gunaltay-havacilik/valkyrie-v3-pcb/README.md

# Valkyrie Flight Control Computer V3.1

Made using primarily KiCad version 9.0<br/>
Some 3D files might not be assigned correctly. You have been warned.<br/>
Uses JLCPCB JLC04161H-7628 stackup, 4 layer.
