gunaltay-havacilik/valkyrie-v3-pcb/3d-files/SMA CONNECTOR--3DModel-STEP-1.STEP

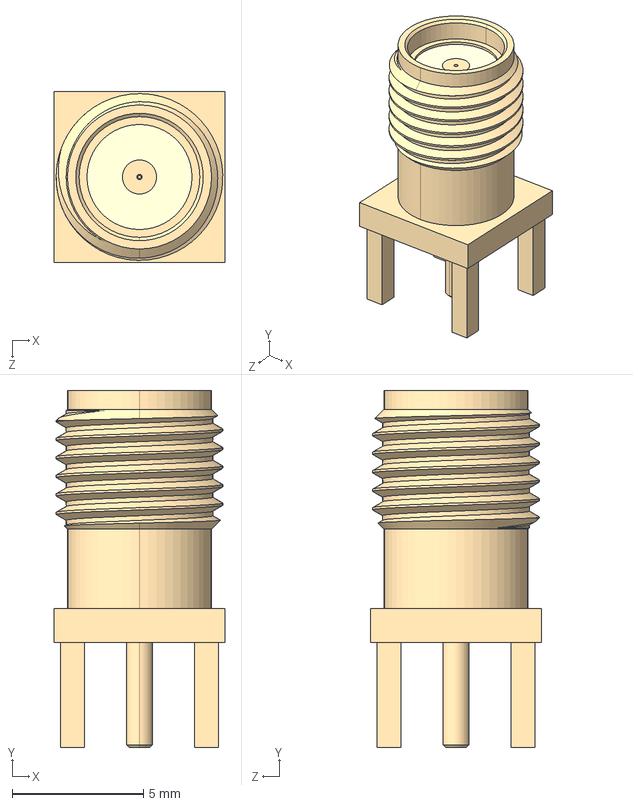
[picture p1: CAD file, 2025-05-14]
3d-files/SMA CONNECTOR--3DModel-STEP-1.STEP
6.50 x 13.6 x 6.50 mm
