gunaltay-havacilik/valkyrie-v3-pcb/3d-files/XH311HU-IV07E--3DModel-STEP-269445.STEP

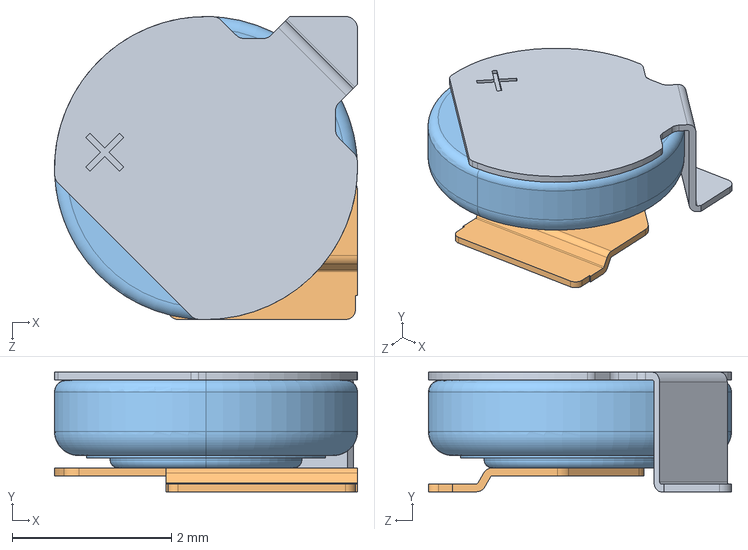
[picture p3: CAD file, 2025-02-26]
3d-files/XH311HU-IV07E--3DModel-STEP-269445.STEP
3.80 x 1.50 x 3.80 mm
