gunaltay-havacilik/valkyrie-v3-pcb/3d-files/CON-SMA-EDGE-S.step

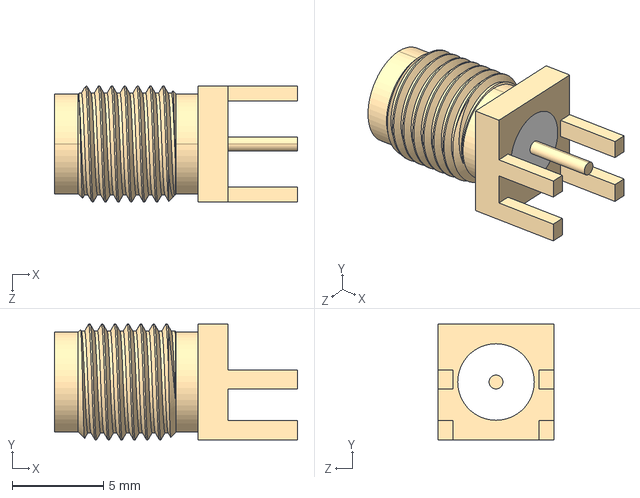
[picture p4: CAD file, 2025-02-26]
3d-files/CON-SMA-EDGE-S.step
13.3 x 6.35 x 6.35 mm
