gunaltay-havacilik/valkyrie-v3-pcb/3d-files/DR125 series.stp

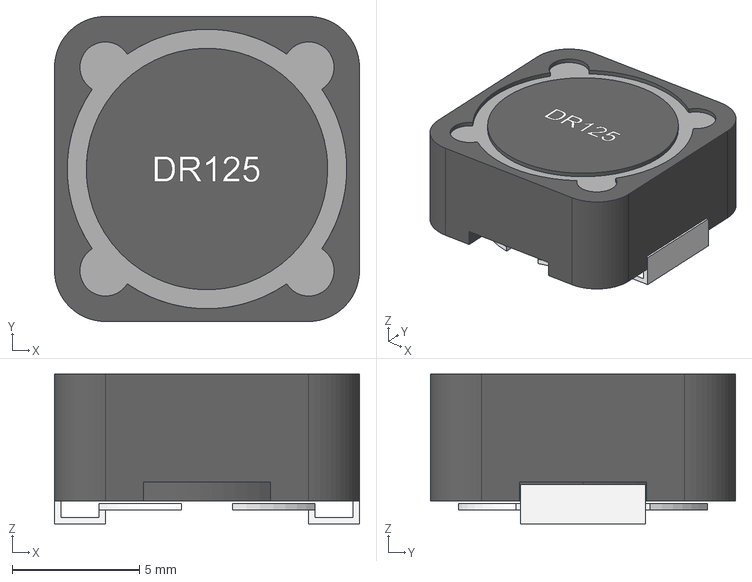
[picture p5: CAD file, 2025-02-26]
3d-files/DR125 series.stp
12.0 x 12.0 x 5.90 mm
