gunaltay-havacilik/valkyrie-v3-pcb/3d-files/L86-M33--3DModel-STEP-56544.STEP

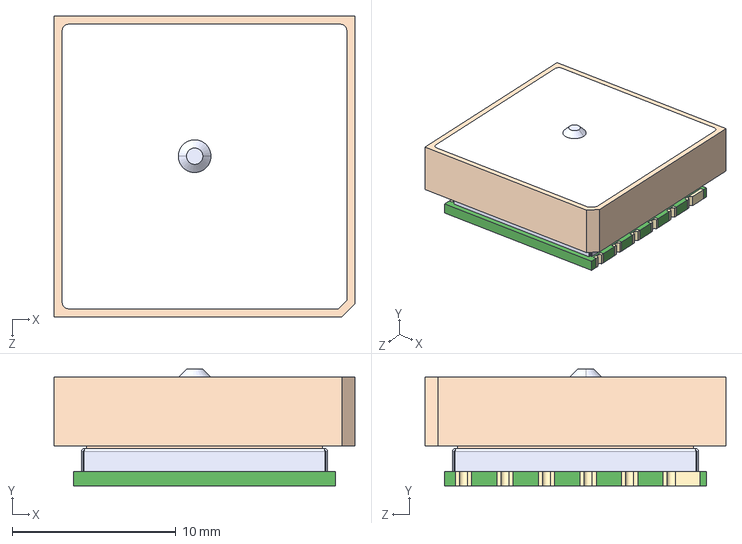
[picture p6: CAD file, 2025-02-26]
3d-files/L86-M33--3DModel-STEP-56544.STEP
18.4 x 7.15 x 18.4 mm
