gunaltay-havacilik/valkyrie-v3-pcb/3d-files/E22-400T30XX.stp

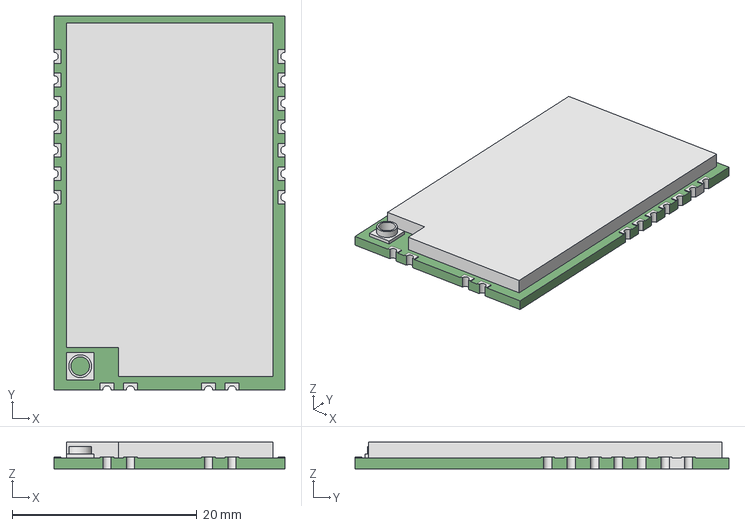
[picture p7: CAD file, 2025-02-26]
3d-files/E22-400T30XX.stp
25.0 x 40.5 x 2.90 mm
