gunaltay-havacilik/valkyrie-v3-pcb/3d-files/XT30PW-M--3DModel-STEP-269445.STEP

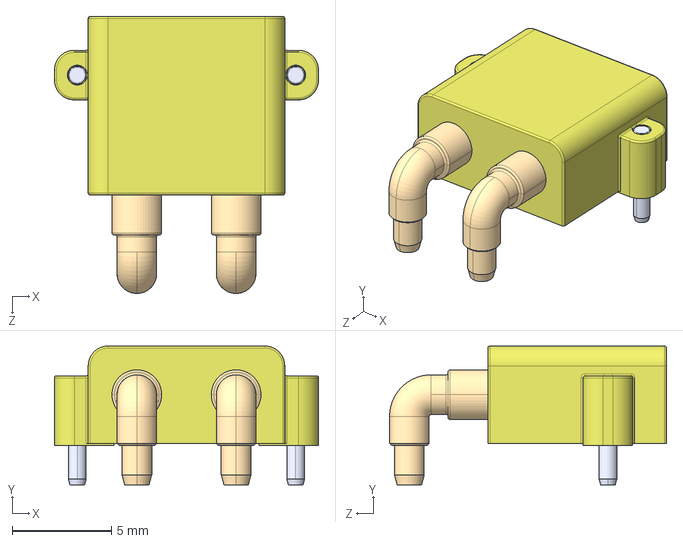
[picture p8: CAD file, 2025-02-26]
3d-files/XT30PW-M--3DModel-STEP-269445.STEP
13.3 x 7.00 x 14.0 mm
