gunaltay-havacilik/valkyrie-v3-pcb/valkyriev3.kicad_pcb

## KiCad design valkyriev3.kicad_pcb (2025-08-03)

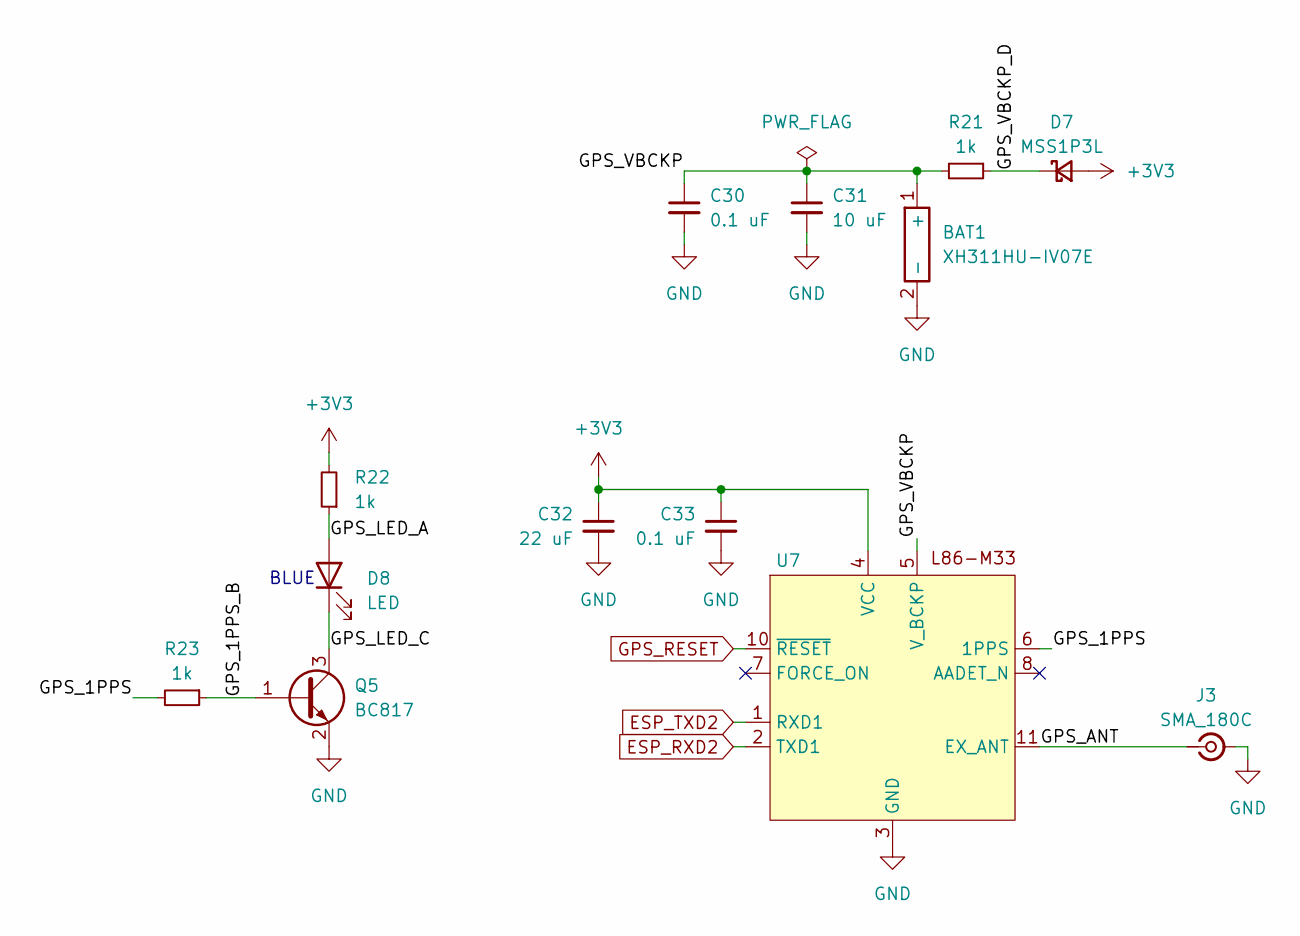
[picture p9: schematic GPS.kicad_sch, Valkyrie Flight Computer V3]

Parts:
BAT1: XH311HU-IV07E
C30, C33: 0.1 uF; C_0603_1608Metric
C31: 10 uF; C_0603_1608Metric
C32: 22 uF; C_0603_1608Metric
D7: MSS1P3L; D_MicroSMP_AK
D8: LED; LED_0603_1608Metric
J3: SMA_180C; SMA_Amphenol_132134-16_Vertical
Q5: BC817; SOT-23
R21, R22, R23: 1k; R_0603_1608Metric
U7: Quectel_L86-M33

Connections:
+3V3: C32.1, C33.1, D7.2 (A), R22.2, U7.4 (VCC); also elsewhere on the board
/GPS/GPS_1PPS: R23.2, U7.6 (1PPS)
/GPS/GPS_1PPS_B: Q5.1 (B), R23.1
/GPS/GPS_ANT: J3.1 (In), U7.11 (EX_ANT)
/GPS/GPS_LED_A: D8.2 (A), R22.1
/GPS/GPS_LED_C: D8.1 (K), Q5.3 (C)
/GPS/GPS_VBCKP: BAT1.1 (+), C30.1, C31.1, R21.2, U7.5 (V_BCKP)
/GPS/GPS_VBCKP_D: D7.1 (K), R21.1
ESP_RXD2: U7.2 (TXD1); also elsewhere on the board
ESP_TXD2: U7.1 (RXD1); also elsewhere on the board
GND: BAT1.2 (-), C30.2, C31.2, C32.2, C33.2, J3.2 (Ext), Q5.2 (E), U7.3 (GND), U7.12 (GND); also elsewhere on the board
GPS_RESET: U7.10 (~RESET); also elsewhere on the board

Notes on the sheet:
BLUE

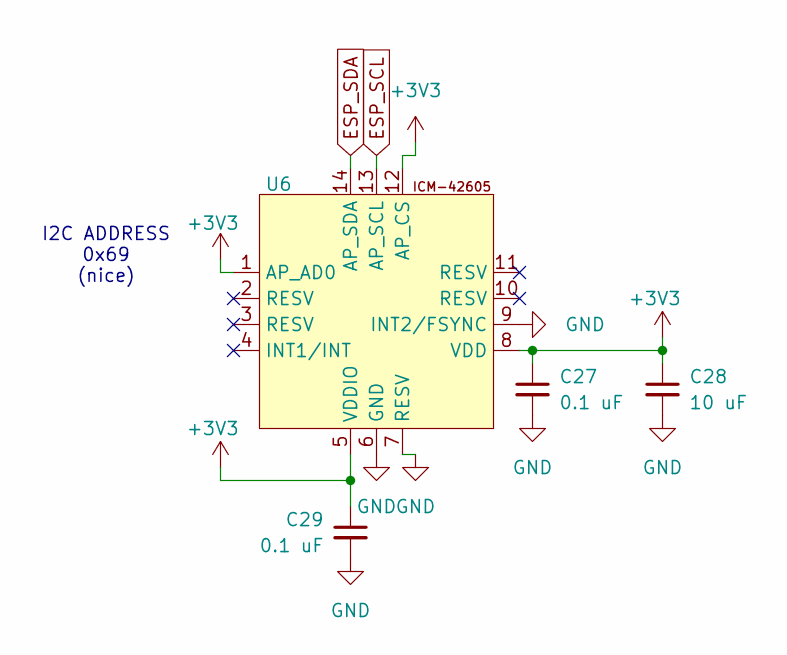
[picture p10: schematic IMU.kicad_sch, Valkyrie Flight Computer V3]

Parts:
C27, C29: 0.1 uF; C_0603_1608Metric
C28: 10 uF; C_0603_1608Metric
U6: LGA-14_3x2.5mm_P0.5mm_LayoutBorder3x4y

Connections:
+3V3: C27.1, C28.1, C29.1, U6.1 (AP_AD0), U6.5 (VDDIO), U6.8 (VDD), U6.12 (AP_CS); also elsewhere on the board
ESP_SCL: U6.13 (AP_SCL); also elsewhere on the board
ESP_SDA: U6.14 (AP_SDA); also elsewhere on the board
GND: C27.2, C28.2, C29.2, U6.6 (GND), U6.7 (RESV), U6.9 (INT2/FSYNC); also elsewhere on the board

Notes on the sheet:
I2C ADDRESS 0x69 (nice)

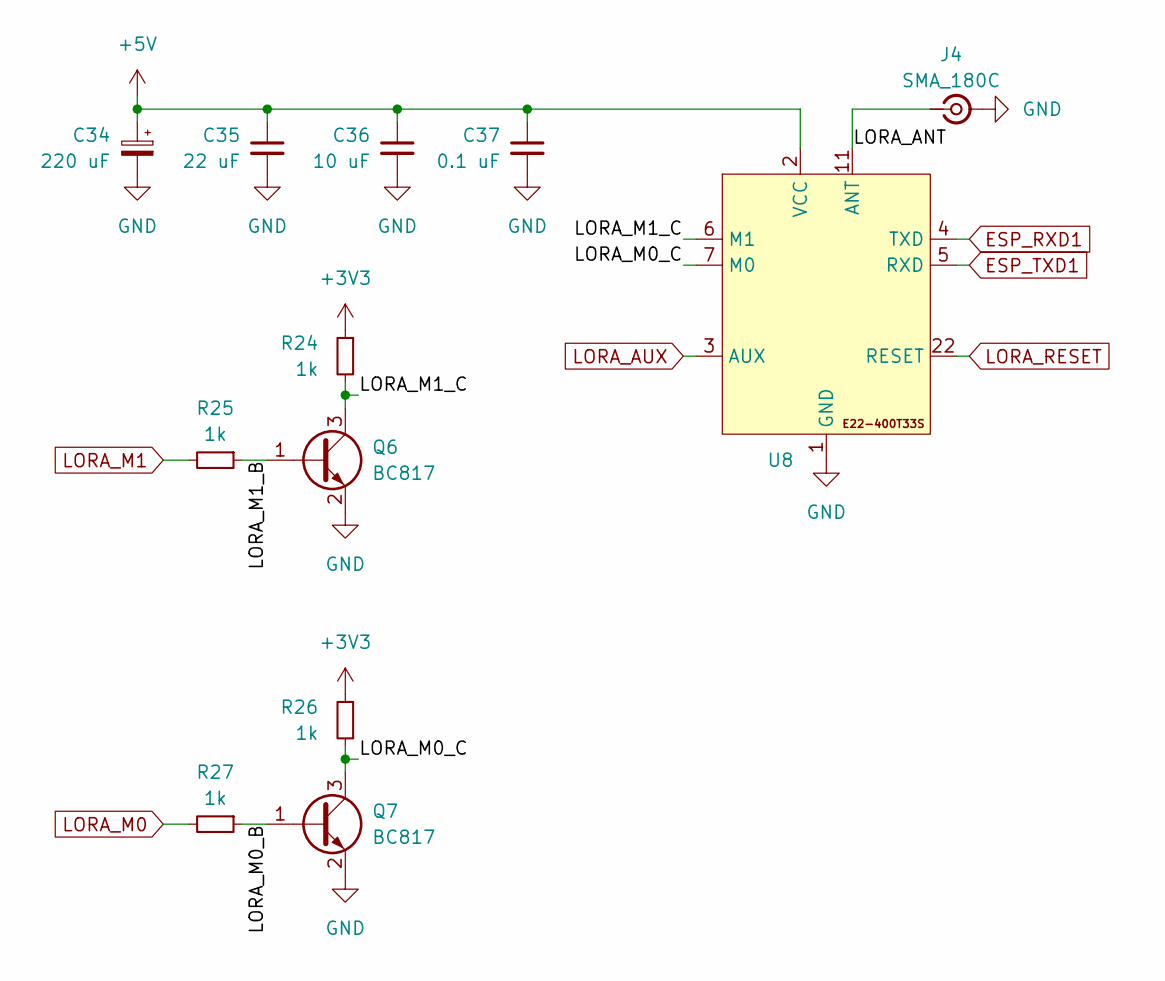
[picture p11: schematic communications.kicad_sch, Valkyrie Flight Computer V3]

Parts:
C34: 220 uF; CP_Elec_6.3x7.7
C35: 22 uF; C_0603_1608Metric
C36: 10 uF; C_0603_1608Metric
C37: 0.1 uF; C_0603_1608Metric
J4: SMA_180C; SMA_Amphenol_132134-16_Vertical
Q6, Q7: BC817; SOT-23
R24, R25, R26, R27: 1k; R_0603_1608Metric
U8: E22-400T33S

Connections:
+3V3: R24.1, R26.1; also elsewhere on the board
+5V: C34.1, C35.1, C36.1, C37.1, U8.2 (VCC); also elsewhere on the board
/Communications/LORA_ANT: J4.1 (In), U8.11 (ANT)
/Communications/LORA_M0_B: Q7.1 (B), R27.1
/Communications/LORA_M0_C: Q7.3 (C), R26.2, U8.7 (M0)
/Communications/LORA_M1_B: Q6.1 (B), R25.1
/Communications/LORA_M1_C: Q6.3 (C), R24.2, U8.6 (M1)
ESP_RXD1: U8.4 (TXD); also elsewhere on the board
ESP_TXD1: U8.5 (RXD); also elsewhere on the board
GND: C34.2, C35.2, C36.2, C37.2, J4.2 (Ext), Q6.2 (E), Q7.2 (E), U8.1 (GND), U8.12 (GND), U8.13 (GND), U8.14 (GND), U8.23 (GND); also elsewhere on the board
LORA_AUX: U8.3 (AUX); also elsewhere on the board
LORA_M0: R27.2; also elsewhere on the board
LORA_M1: R25.2; also elsewhere on the board
LORA_RESET: U8.22 (RESET); also elsewhere on the board

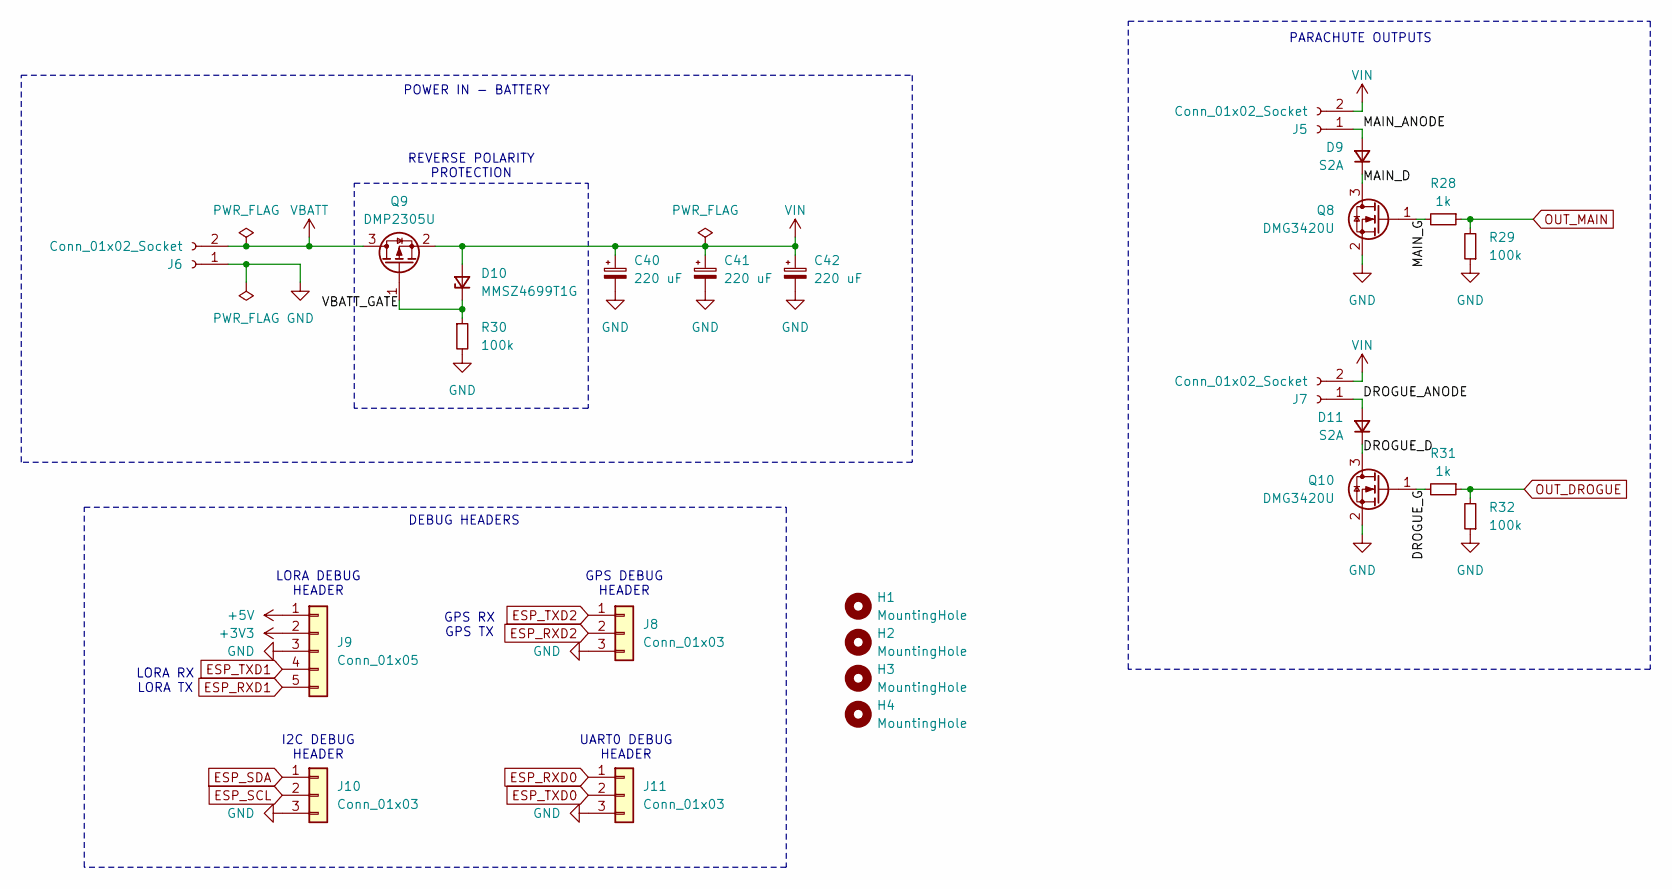
[picture p12: schematic connectors.kicad_sch, Valkyrie Flight Computer V3]

Parts:
C40, C41, C42: 220 uF; CP_Elec_6.3x7.7
D9, D11: S2A; D_SMB
D10: MMSZ4699T1G; D_SOD-123
H1, H2, H3, H4: MountingHole; MountingHole_2.2mm_M2
J5, J6, J7: Conn_01x02_Socket; AMASS_XT30PW-M_1x02_P2.50mm_Horizontal
J8, J10, J11: Conn_01x03; PinHeader_1x03_P2.54mm_Vertical
J9: Conn_01x05; PinHeader_1x05_P2.54mm_Vertical
Q8, Q10: DMG3420U; SOT-23
Q9: DMP2305U; SOT-23
R28, R31: 1k; R_0603_1608Metric
R29, R30, R32: 100k; R_0603_1608Metric

Connections:
+3V3: J9.2; also elsewhere on the board
+5V: J9.1; also elsewhere on the board
/Connectors/DROGUE_ANODE: D11.2 (A), J7.1
/Connectors/DROGUE_D: D11.1 (K), Q10.3 (D)
/Connectors/DROGUE_G: Q10.1 (G), R31.2
/Connectors/MAIN_ANODE: D9.2 (A), J5.1
/Connectors/MAIN_D: D9.1 (K), Q8.3 (D)
/Connectors/MAIN_G: Q8.1 (G), R28.2
/Connectors/VBATT_GATE: D10.1 (K), Q9.1 (G), R30.1
ESP_RXD0: J11.1; also elsewhere on the board
ESP_RXD1: J9.5; also elsewhere on the board
ESP_RXD2: J8.2; also elsewhere on the board
ESP_SCL: J10.2; also elsewhere on the board
ESP_SDA: J10.1; also elsewhere on the board
ESP_TXD0: J11.2; also elsewhere on the board
ESP_TXD1: J9.4; also elsewhere on the board
ESP_TXD2: J8.1; also elsewhere on the board
GND: C40.2, C41.2, C42.2, J6.1, J8.3, J9.3, J10.3, J11.3, Q8.2 (S), Q10.2 (S), R29.1, R30.2, R32.1; also elsewhere on the board
OUT_DROGUE: R31.1, R32.2; also elsewhere on the board
OUT_MAIN: R28.1, R29.2; also elsewhere on the board
VBATT: J6.2, Q9.3 (D)
VIN: C40.1, C41.1, C42.1, D10.2 (A), J5.2, J7.2, Q9.2 (S); also elsewhere on the board

Notes on the sheet:
LORA DEBUG HEADER
POWER IN - BATTERY
LORA RX LORA TX
PARACHUTE OUTPUTS
I2C DEBUG HEADER
UART0 DEBUG HEADER
DEBUG HEADERS
REVERSE POLARITY PROTECTION
GPS DEBUG HEADER
GPS RX GPS TX

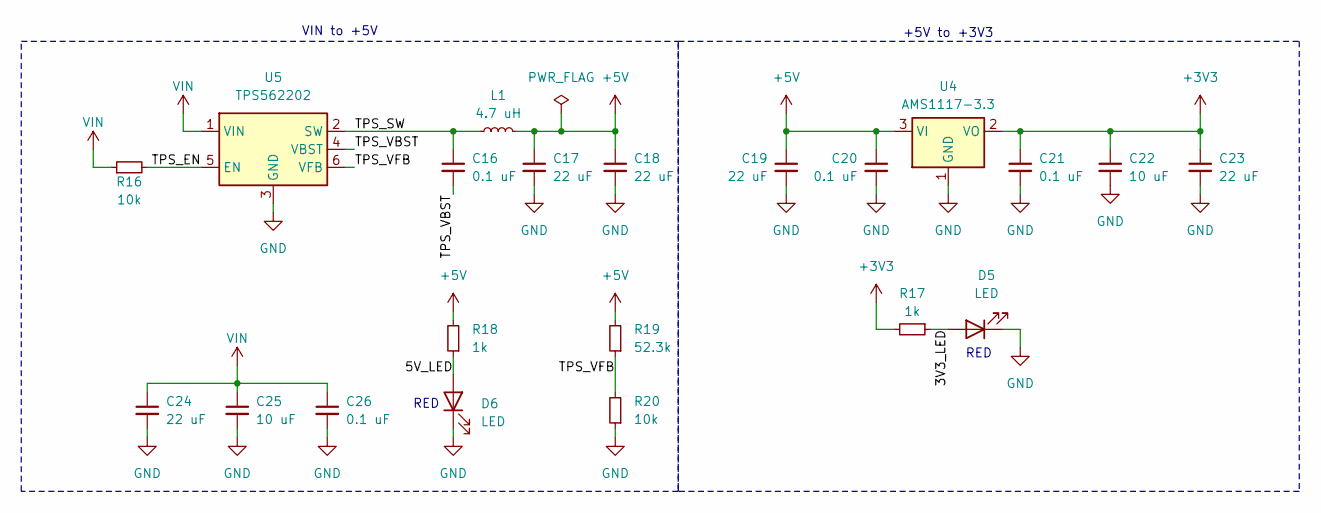
[picture p13: schematic power.kicad_sch, Valkyrie Flight Computer V3]

Parts:
C16, C20, C21: 0.1 uF; C_0603_1608Metric
C17, C18, C19, C23: 22 uF; C_0603_1608Metric
C22: 10 uF; C_0603_1608Metric
C24: 22 uF; C_0805_2012Metric
C25: 10 uF; C_0805_2012Metric
C26: 0.1 uF; C_0805_2012Metric
D5, D6: LED; LED_0603_1608Metric
L1: 4.7 uH; HPC 5020NF
R16, R20: 10k; R_0603_1608Metric
R17, R18: 1k; R_0603_1608Metric
R19: 52.3k; R_0603_1608Metric
U4: AMS1117-3.3; SOT-223-3_TabPin2
U5: TPS562202; SOT-563

Connections:
+3V3: C21.1, C22.1, C23.1, R17.2, U4.2 (VO); also elsewhere on the board
+5V: C17.1, C18.1, C19.1, C20.1, L1.2, R18.2, R19.2, U4.3 (VI); also elsewhere on the board
/Power/3V3_LED: D5.2 (A), R17.1
/Power/5V_LED: D6.2 (A), R18.1
/Power/TPS_EN: R16.2, U5.5 (EN)
/Power/TPS_SW: C16.1, L1.1, U5.2 (SW)
/Power/TPS_VBST: C16.2, U5.4 (VBST)
/Power/TPS_VFB: R19.1, R20.2, U5.6 (VFB)
GND: C17.2, C18.2, C19.2, C20.2, C21.2, C22.2, C23.2, C24.2, C25.2, C26.2, D5.1 (K), D6.1 (K), R20.1, U4.1 (GND), U5.3 (GND); also elsewhere on the board
VIN: C24.1, C25.1, C26.1, R16.1, U5.1 (VIN); also elsewhere on the board

Notes on the sheet:
RED
VIN to +5V
+5V to +3V3

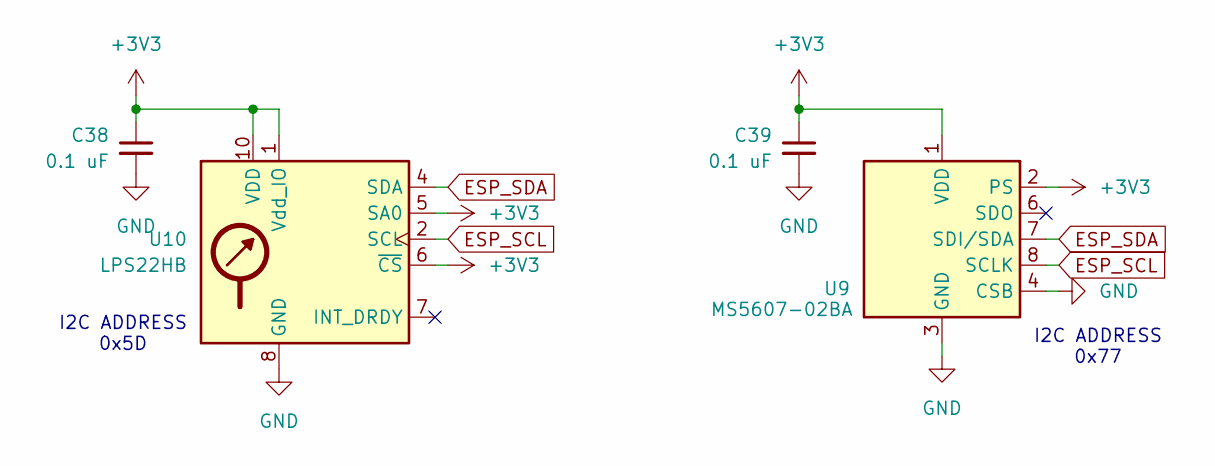
[picture p14: schematic Baro.kicad_sch, Valkyrie Flight Computer V3]

Parts:
C38, C39: 0.1 uF; C_0603_1608Metric
U9: MS5607-02BA; LGA-8_3x5mm_P1.25mm
U10: LPS22HB; ST_HLGA-10_2x2mm_P0.5mm_LayoutBorder3x2y

Connections:
+3V3: C38.1, C39.1, U9.1 (VDD), U9.2 (PS), U10.1 (Vdd_IO), U10.5 (SA0), U10.6 (~CS), U10.10 (VDD); also elsewhere on the board
ESP_SCL: U9.8 (SCLK), U10.2 (SCL); also elsewhere on the board
ESP_SDA: U9.7 (SDI/SDA), U10.4 (SDA); also elsewhere on the board
GND: C38.2, C39.2, U9.3 (GND), U9.4 (CSB), U9.5 (CSB), U10.3 (GND), U10.8 (GND), U10.9 (GND); also elsewhere on the board

Notes on the sheet:
I2C ADDRESS 0x5D
I2C ADDRESS 0x77

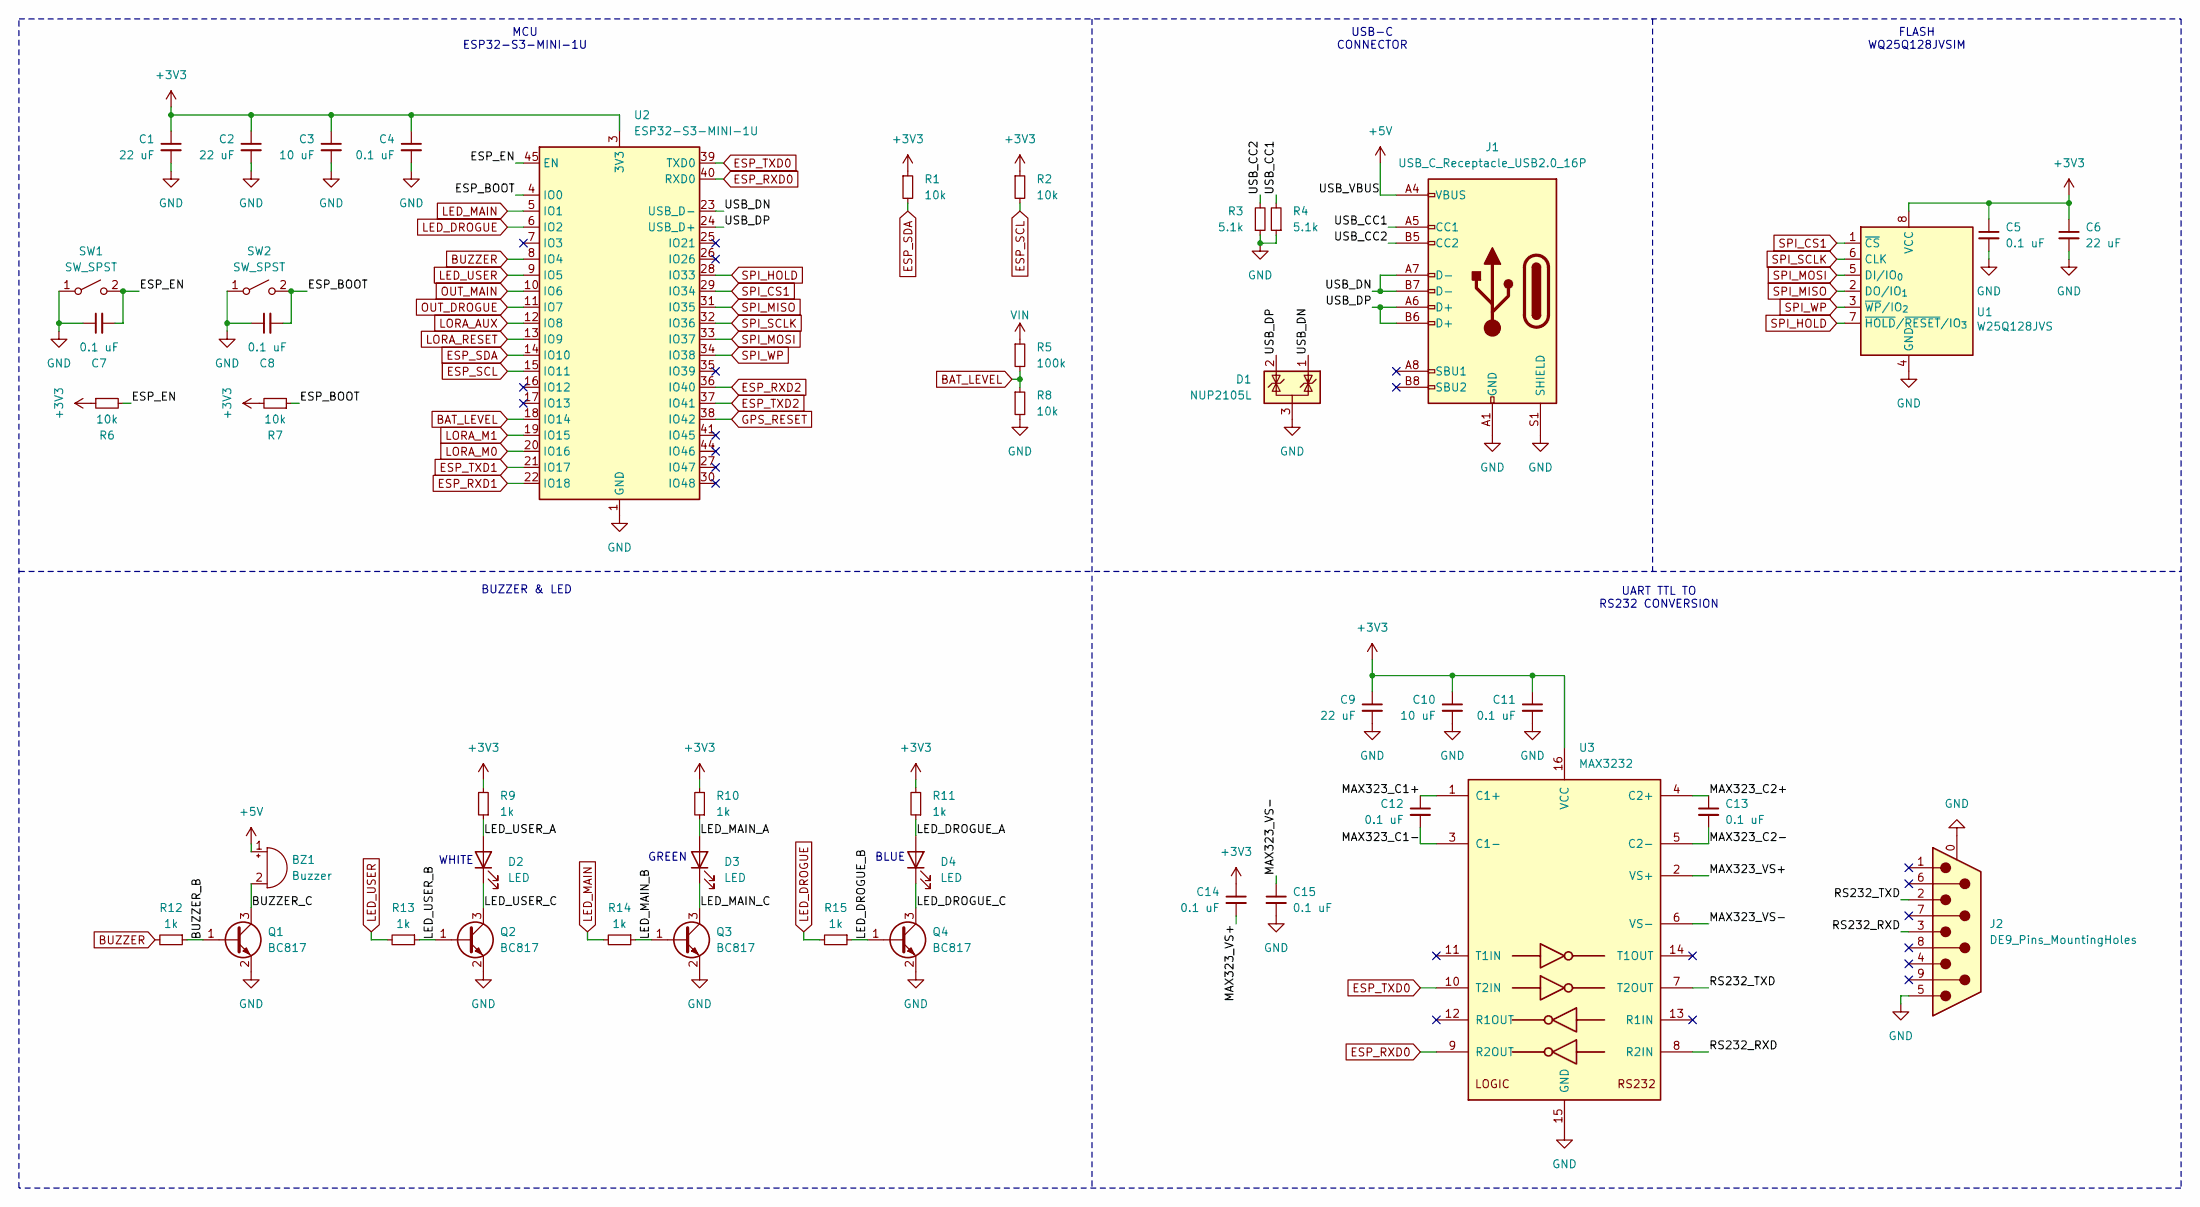
[picture p15: schematic MCU.kicad_sch, Valkyrie Flight Computer V3]

Parts:
BZ1: Buzzer; Buzzer_12x9.5RM7.6
C1, C2, C6, C9: 22 uF; C_0603_1608Metric
C3, C10: 10 uF; C_0603_1608Metric
C4, C5, C7, C8, C11, C12, C13, C14, C15: 0.1 uF; C_0603_1608Metric
D1: NUP2105L; SOT-23
D2, D3, D4: LED; LED_0603_1608Metric
J1: USB_C_Receptacle_USB2.0_16P; USB_C_Receptacle_GCT_USB4105-xx-A_16P_TopMnt_Horizontal
J2: DE9_Pins_MountingHoles; DSUB-9_Pins_Horizontal_P2.77x2.84mm_EdgePinOffset7.70mm_Hou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
Q1, Q2, Q3, Q4: BC817; SOT-23
R1, R2, R6, R7, R8: 10k; R_0603_1608Metric
R3, R4: 5.1k; R_0603_1608Metric
R5: 100k; R_0603_1608Metric
R9, R10, R11, R12, R13, R14, R15: 1k; R_0603_1608Metric
SW1, SW2: SW_SPST; SW_Tactile_SPST_NO_Straight_CK_PTS636Sx25SMTRLFS
U1: W25Q128JVS; SOIC-8_5.3x5.3mm_P1.27mm
U2: ESP32-S3-MINI-1U; ESP32-S2-MINI-1U
U3: MAX3232; TSSOP-16_4.4x5mm_P0.65mm

Connections:
+3V3: C1.1, C2.1, C3.1, C4.1, C5.1, C6.1, C9.1, C10.1, C11.1, C14.1, R1.1, R2.1, R6.1, R7.2, R9.2, R10.2, R11.2, U1.8 (VCC), U2.3 (3V3), U3.16 (VCC); also elsewhere on the board
+5V: BZ1.1 (+), J1.A4 (VBUS), J1.A9 (VBUS), J1.B4 (VBUS), J1.B9 (VBUS); also elsewhere on the board
/MCU/BUZZER_B: Q1.1 (B), R12.1
/MCU/BUZZER_C: BZ1.2 (-), Q1.3 (C)
/MCU/ESP_BOOT: C8.2, R7.1, SW2.2 (B), U2.4 (IO0)
/MCU/ESP_EN: C7.2, R6.2, SW1.2 (B), U2.45 (EN)
/MCU/LED_DROGUE_A: D4.2 (A), R11.1
/MCU/LED_DROGUE_B: Q4.1 (B), R15.1
/MCU/LED_DROGUE_C: D4.1 (K), Q4.3 (C)
/MCU/LED_MAIN_A: D3.2 (A), R10.1
/MCU/LED_MAIN_B: Q3.1 (B), R14.1
/MCU/LED_MAIN_C: D3.1 (K), Q3.3 (C)
/MCU/LED_USER_A: D2.2 (A), R9.1
/MCU/LED_USER_B: Q2.1 (B), R13.1
/MCU/LED_USER_C: D2.1 (K), Q2.3 (C)
/MCU/MAX323_C1+: C12.1, U3.1 (C1+)
/MCU/MAX323_C1-: C12.2, U3.3 (C1-)
/MCU/MAX323_C2+: C13.1, U3.4 (C2+)
/MCU/MAX323_C2-: C13.2, U3.5 (C2-)
/MCU/MAX323_VS+: C14.2, U3.2 (VS+)
/MCU/MAX323_VS-: C15.1, U3.6 (VS-)
/MCU/RS232_RXD: J2.3, U3.8 (R2IN)
/MCU/RS232_TXD: J2.2, U3.7 (T2OUT)
/MCU/USB_CC1: J1.A5 (CC1), R4.2
/MCU/USB_CC2: J1.B5 (CC2), R3.2
/MCU/USB_DN: D1.1 (K), J1.A7 (D-), J1.B7 (D-), U2.23 (USB_D-)
/MCU/USB_DP: D1.2 (K), J1.A6 (D+), J1.B6 (D+), U2.24 (USB_D+)
BAT_LEVEL: R5.2, R8.1, U2.18 (IO14)
BUZZER: R12.2, U2.8 (IO4)
ESP_RXD0: U2.40 (RXD0), U3.9 (R2OUT); also elsewhere on the board
ESP_RXD1: U2.22 (IO18); also elsewhere on the board
ESP_RXD2: U2.36 (IO40); also elsewhere on the board
ESP_SCL: R2.2, U2.15 (IO11); also elsewhere on the board
ESP_SDA: R1.2, U2.14 (IO10); also elsewhere on the board
ESP_TXD0: U2.39 (TXD0), U3.10 (T2IN); also elsewhere on the board
ESP_TXD1: U2.21 (IO17); also elsewhere on the board
ESP_TXD2: U2.37 (IO41); also elsewhere on the board
GND: C1.2, C2.2, C3.2, C4.2, C5.2, C6.2, C7.1, C8.1, C9.2, C10.2, C11.2, C15.2, D1.3 (A), J1.A1 (GND), J1.A12 (GND), J1.B1 (GND), J1.B12 (GND), J1.S1 (SHIELD), J2.0 (PAD), J2.5, Q1.2 (E), Q2.2 (E), Q3.2 (E), Q4.2 (E), R3.1, R4.1, R8.2, SW1.1 (A), SW2.1 (A), U1.4 (GND), U2.1 (GND), U2.2 (GND), U2.42 (GND), U2.43 (GND), U2.46 (GND), U2.47 (GND), U2.48 (GND), U2.49 (GND), U2.50 (GND), U2.51 (GND), U2.52 (GND), U2.53 (GND), U2.54 (GND), U2.55 (GND), U2.56 (GND), U2.57 (GND), U2.58 (GND), U2.59 (GND), U2.60 (GND), U2.61 (GND), U2.62 (GND), U2.63 (GND), U2.64 (GND), U2.65 (GND), U3.15 (GND); also elsewhere on the board
GPS_RESET: U2.38 (IO42); also elsewhere on the board
LED_DROGUE: R15.2, U2.6 (IO2)
LED_MAIN: R14.2, U2.5 (IO1)
LED_USER: R13.2, U2.9 (IO5)
LORA_AUX: U2.12 (IO8); also elsewhere on the board
LORA_M0: U2.20 (IO16); also elsewhere on the board
LORA_M1: U2.19 (IO15); also elsewhere on the board
LORA_RESET: U2.13 (IO9); also elsewhere on the board
OUT_DROGUE: U2.11 (IO7); also elsewhere on the board
OUT_MAIN: U2.10 (IO6); also elsewhere on the board
SPI_CS1: U1.1 (~CS), U2.29 (IO34)
SPI_HOLD: U1.7 (~HOLD/~RESET/IO_{3}), U2.28 (IO33)
SPI_MISO: U1.2 (DO/IO_{1}), U2.31 (IO35)
SPI_MOSI: U1.5 (DI/IO_{0}), U2.33 (IO37)
SPI_SCLK: U1.6 (CLK), U2.32 (IO36)
SPI_WP: U1.3 (~WP/IO_{2}), U2.34 (IO38)
VIN: R5.1; also elsewhere on the board

Notes on the sheet:
USB-C CONNECTOR
UART TTL TO RS232 CONVERSION
GREEN
WHITE
BLUE
FLASH WQ25Q128JVSIM
MCU ESP32-S3-MINI-1U
BUZZER & LED

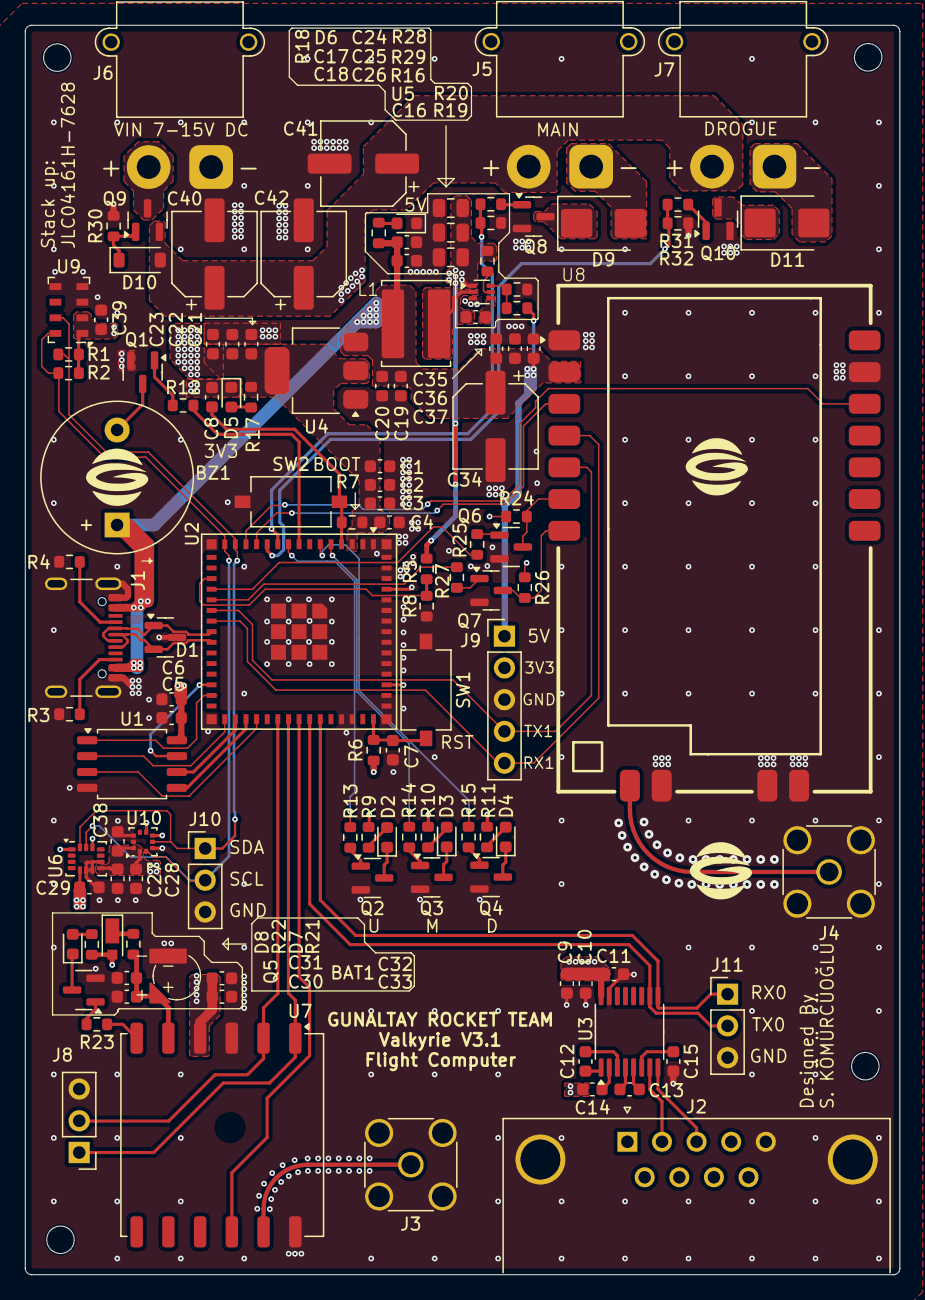
[picture p16: board valkyriev3.kicad_pcb from above]

Board: 4 copper layers, 70.0 x 100.0 mm, 125 parts (0 on the bottom side), 81 nets.
