gunaltay-havacilik/valkyrie-v3-pcb/todo_list.txt

- LoRa antenini sağa çek
    -ok
- USB VBUS -> DIODE -> 5V (pil ve usb aynı anda takılınca pc yanmasın)
    -iptal
- LoRa M0 ve M1 pinleri ve ESP GPIO pinleri arasına bjt, esp tek başına süremiyor.
    -ok
- LPS22HB ve ICM-42605 arası mesafeyi arttır? (dunno)
    -üşendim
- Main ve drogue çıkışlarına akım limitleme devresi
    -yok
- GPS için RX ve TX'i değiştir (via kullanmamak için)
    -ok
- LoRa RX ve TX isimlendirmeyi değiştir (RX aslında TX şu anda)
    -ok
- türk bayrağı ve atatürk
    -ok
