gunaltay-havacilik/valkyrie-v3-pcb/(commit log)

2025-02-22 buzzer sch connections
    [MCU.kicad_sch]
2025-02-23 Wired barometers and GPS up, added misc LEDs, tidy-up
    [Baro.kicad_sch, GPS.kicad_sch, IMU.kicad_sch, MCU.kicad_sch, communications.kicad_sch, connectors.kicad_sch, power.kicad_sch]
2025-02-24 preliminary schematic wired, all footprints assigned, all laid out in PCB editor.
    [Baro.kicad_sch, GPS.kicad_sch, IMU.kicad_sch, MCU.kicad_sch, communications.kicad_sch, connectors.kicad_sch, power.kicad_sch, valkyriev3.kicad_pcb]
2025-02-26 reassigned some footprints, preliminary PCB layout
    [Baro.kicad_sch, GPS.kicad_sch, IMU.kicad_sch, MCU.kicad_sch, communications.kicad_sch, connectors.kicad_sch, power.kicad_sch, valkyriev3.kicad_pcb]
2025-02-26 added missing output diodes, added 3d models, misc. re-laying
    [GPS.kicad_sch, MCU.kicad_sch, connectors.kicad_sch, power.kicad_sch, valkyriev3.kicad_pcb]
2025-02-26 3d model files
    [CON-SMA-EDGE-S.step, DR125 series.stp, E22-400T30XX.stp, ESP32-S3-MINI-1U-N8--3DModel-STEP-56544.STEP, L86-M33--3DModel-STEP-56544.STEP, XH311HU-IV07E--3DModel-STEP-269445.STEP, XT30PW-M--3DModel-STEP-269445.STEP]
2025-02-28 revision of layout. added 3d model of the card
    [connectors.kicad_sch, valkyriev3.kicad_pcb]
2025-04-03 updated some values and routed some preliminary roads
    [MCU.kicad_sch, communications.kicad_sch, valkyriev3.kicad_pcb]
2025-04-04 completed routing. laid out reference designators, information and two anime girls
    [valkyriev3.kicad_pcb]
2025-04-05 Added BOOT and RST labels to their respective buttons
    [valkyriev3.kicad_pcb]
2025-04-05 connected IMU pins 7 and 9 to GND instead of NC
    [IMU.kicad_sch, valkyriev3.kicad_pcb]
2025-04-05 connected missing grounds
    [valkyriev3.kicad_pcb]
2025-04-05 added my name as reviewer to pcb
    [valkyriev3.kicad_pcb]
2025-04-05 fixed unconnected grounds
    [valkyriev3.kicad_pcb]
2025-04-05 added esat's image
    [valkyriev3.kicad_pcb]
2025-04-05 added labels to headers and leds, configured severities of DRC checks
    [valkyriev3.kicad_pcb]
2025-04-05 widened VIN track going to 5V SMPS
    [valkyriev3.kicad_pcb]
2025-04-08 added interactive BOM
2025-05-14 added sma 3d file
    [SMA CONNECTOR--3DModel-STEP-1.STEP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]
2025-05-19 added todo list
    [valkyriev3-B_Cu.gbr, valkyriev3-B_Mask.gbr, valkyriev3-B_Paste.gbr, valkyriev3-B_Silkscreen.gbr, valkyriev3-Edge_Cuts.gbr, valkyriev3-F_Cu.gbr, valkyriev3-F_Mask.gbr, valkyriev3-F_Paste.gbr]
2025-06-22 did some clean-up, did some to-do tasks.
    [Baro.kicad_sch, GPS.kicad_sch, IMU.kicad_sch, MCU.kicad_sch, communications.kicad_sch, connectors.kicad_sch, power.kicad_sch, valkyriev3.kicad_pcb]
2025-07-26 improvements, re-did some tasks. updated step file.
    [MCU.kicad_sch, valkyriev3.kicad_pcb]
2025-08-03 Added more graphics, removed some unnecessary features. moved GPU passive components upper. added switching components to LoRa.
    [GPS.kicad_sch, MCU.kicad_sch, connectors.kicad_sch, power.kicad_sch, valkyriev3.kicad_pcb]
